somedudenamedtony/Resonance/hardware/enclosure/README.md

# Bridge enclosure

Parametric OpenSCAD case for the ESP32-S3 DevKitC-1 style board + a single-18650 battery shield.
STLs for all three variants are in `stl/` (base, lid, stack tray; the shield/cell/esp files are
preview mock-ups, don't print them).

| Variant | Outside (mm) | Ports | Good for |
|---|---|---|---|
| stack | 105 × 38 × 43 | ESP32 ports on the end, charge on the side | smallest footprint, bench |
| slim  | 105 × 68 × 32 | ESP32 ports on the end, charge on the back | velcro to the back of the NanoVNA |
| stick | 173 × 36 × 32 | ESP32 ports on the end, charge on the side | strap to a mast or tripod leg |

Before printing, measure the values marked ★ in `resonance_case.scad` (board sizes, port and
button positions) and re-export:

    openscad -D 'variant="slim"' -D 'part="base"' -o slim-base.stl resonance_case.scad

Print PLA or PETG, 0.2 mm layers, 3 walls, no supports. Base upright, lid upside down.
Snap-fit lid (`fit` = 0.3 mm clearance); the side ON/OFF button gets a flex tab in the wall, the battery LEDs show through slits, and the
ESP32 LEDs show through a light pipe (print the lid in a translucent filament for a glow).
