somedudenamedtony/Resonance/hardware/enclosure/stl/stack-base.stl

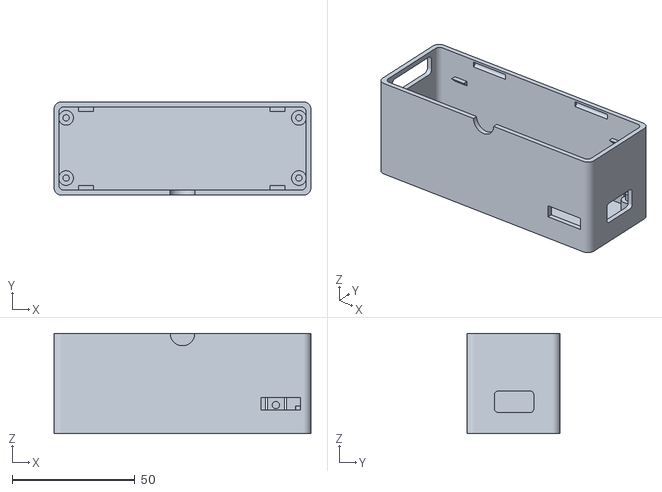
[picture p1: CAD file, 2026-10-26]
hardware/enclosure/stl/stack-base.stl
104.6 x 38.0 x 40.8
