somedudenamedtony/Resonance/hardware/enclosure/stl/stack-lid.stl

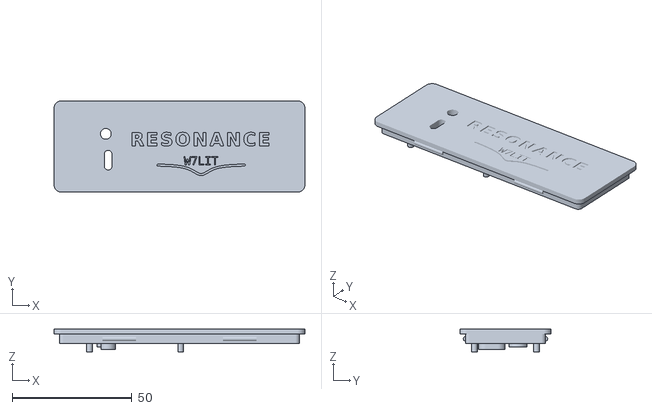
[picture p2: CAD file, 2026-10-26]
hardware/enclosure/stl/stack-lid.stl
104.6 x 38.0 x 9.40
