somedudenamedtony/Resonance/hardware/enclosure/stl/stack-esp.stl

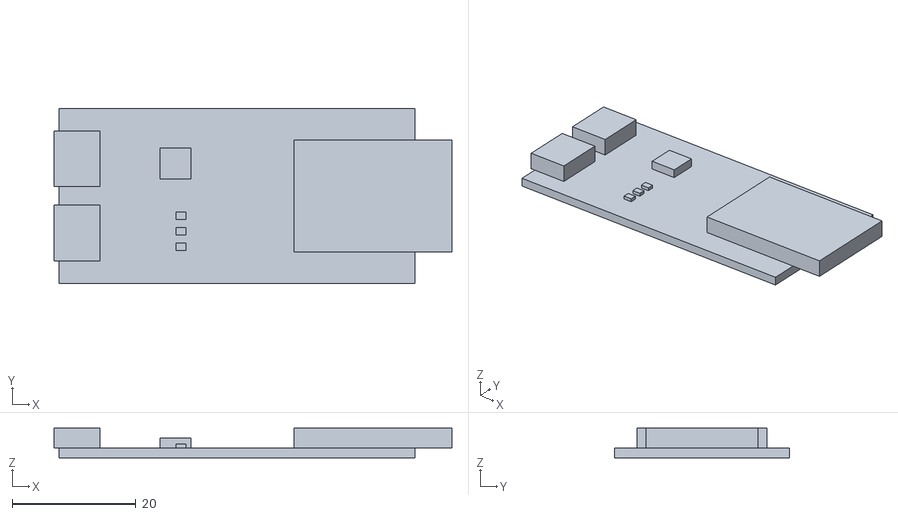
[picture p3: CAD file, 2026-10-26]
hardware/enclosure/stl/stack-esp.stl
64.3 x 28.3 x 4.80
