somedudenamedtony/Resonance/hardware/enclosure/stl/stack-tray.stl

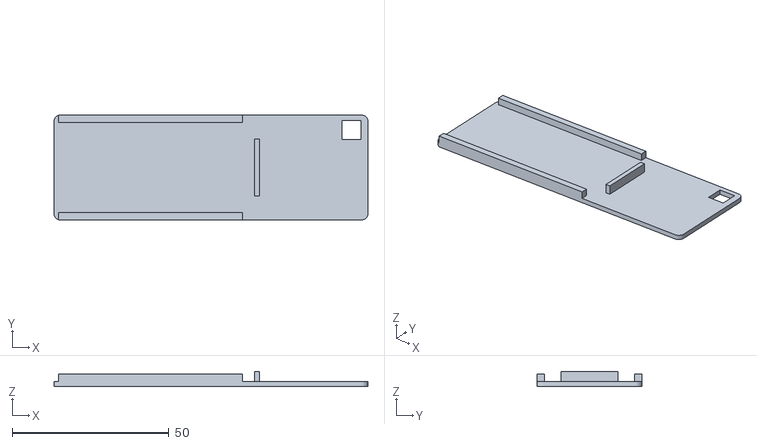
[picture p4: CAD file, 2026-10-25]
hardware/enclosure/stl/stack-tray.stl
100.0 x 33.4 x 4.70
