somedudenamedtony/Resonance/hardware/enclosure/stl/slim-shield.stl

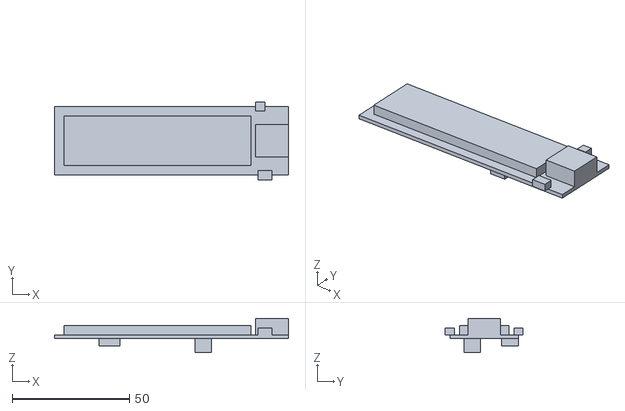
[picture p5: CAD file, 2026-10-25]
hardware/enclosure/stl/slim-shield.stl
100.0 x 33.2 x 14.6
