somedudenamedtony/Resonance/hardware/enclosure/stl/stack-cell.stl

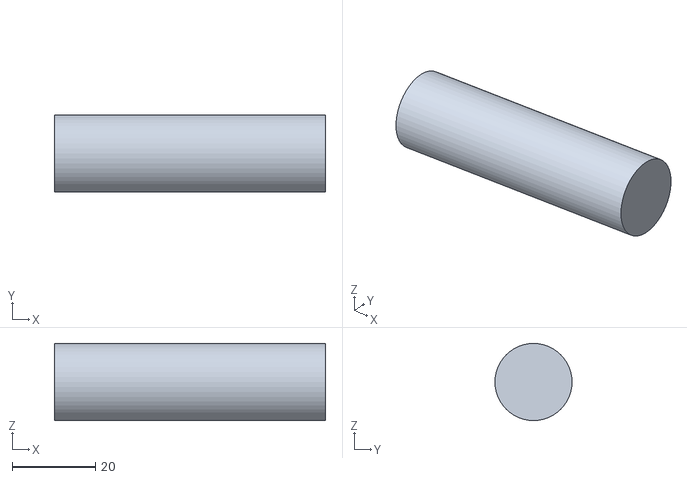
[picture p6: CAD file, 2026-10-25]
hardware/enclosure/stl/stack-cell.stl
65.0 x 18.5 x 18.5
