somedudenamedtony/Resonance/hardware/enclosure/stl/stick-base.stl

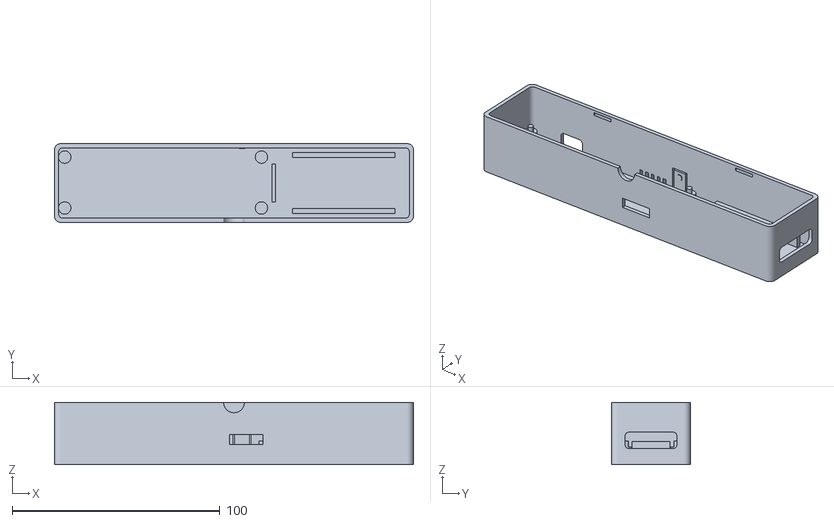
[picture p7: CAD file, 2026-10-25]
hardware/enclosure/stl/stick-base.stl
172.9 x 38.0 x 30.0
