somedudenamedtony/Resonance/hardware/enclosure/stl/stick-lid.stl

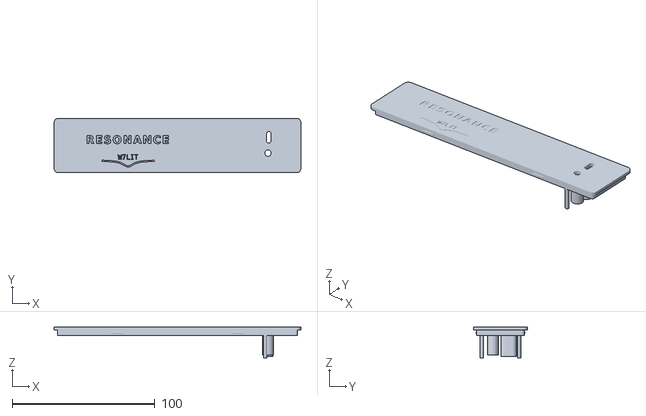
[picture p8: CAD file, 2026-10-25]
hardware/enclosure/stl/stick-lid.stl
172.9 x 38.0 x 21.7
