somedudenamedtony/Resonance/hardware/enclosure/stl/slim-base.stl

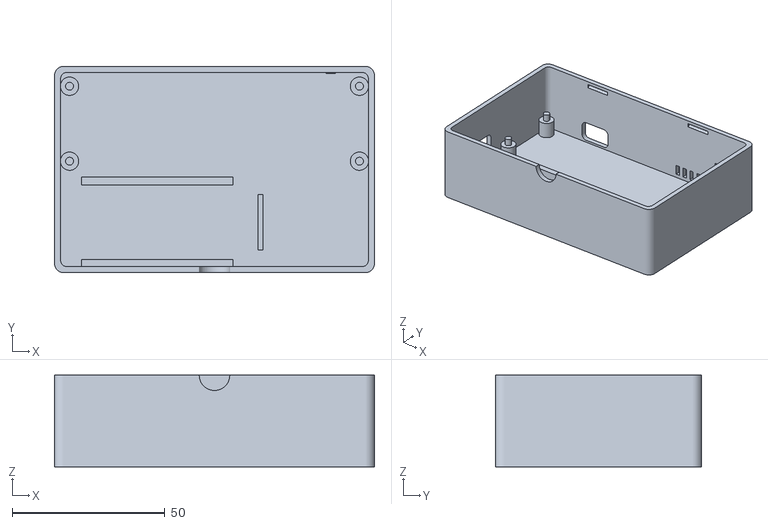
[picture p9: CAD file, 2026-10-25]
hardware/enclosure/stl/slim-base.stl
104.6 x 67.4 x 30.0
