somedudenamedtony/Resonance/hardware/enclosure/stl/slim-lid.stl

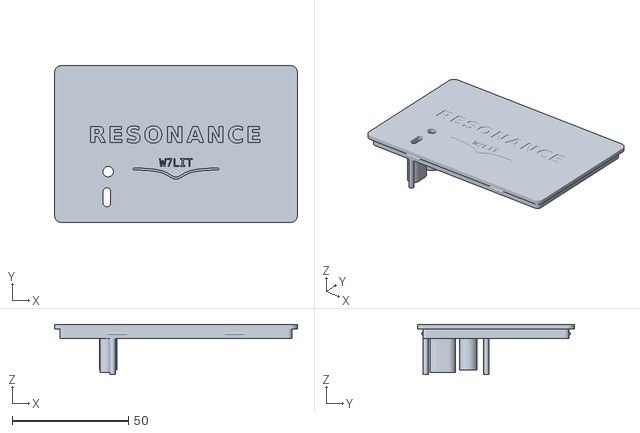
[picture p10: CAD file, 2026-10-25]
hardware/enclosure/stl/slim-lid.stl
104.6 x 67.4 x 21.7
