somedudenamedtony/Resonance/hardware/enclosure/stl/slim-cell.stl

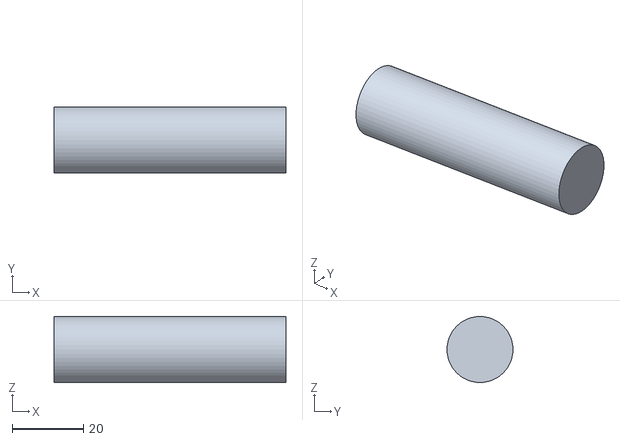
[picture p11: CAD file, 2026-10-25]
hardware/enclosure/stl/slim-cell.stl
65.0 x 18.5 x 18.5
