somedudenamedtony/Resonance/(list of files, cad)

Other CAD files:
hardware/enclosure/stl/stack-shield.stl
hardware/enclosure/stl/stick-shield.stl
hardware/enclosure/stl/stick-esp.stl
hardware/enclosure/stl/slim-esp.stl
