somedudenamedtony/Resonance/(commit log)

2026-10-16 Scaffold monorepo and start analysis library
    npm workspaces (analysis, app), shared tsconfig, README with
    milestone status checklist. Analysis: complex math, SWR/Z/RL,
    1-port OSL calibration with interpolation, standard check,
    sweep metrics (min SWR, resonance, bandwidth), US band plan.
    Claude-Session: https://claude.ai/code/session_019vR4sP8fijH1FKbvyV13yw
2026-10-16 Add spec, protocol doc, firmware skeleton and CI
    docs/SPEC.md (exported product spec), docs/PROTOCOL.md (v1 wire
    format, binary frame layout), PlatformIO ESP-IDF skeleton with a
    16 MB partition table and M1 plan, GitHub Actions for typecheck,
    test and build.
    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
    [partitions.csv]
2026-10-16 App: bridge protocol, simulator, Home and Check flow
    Preact + Vite app (17 KB gzipped). Protocol v1 codec with binary
    scan frames, BridgeClient with reconnects and progressive scans,
    in-browser simulated bridge + NanoVNA with antenna presets,
    Home, Check my antenna (band picker, live SWR trace, verdict,
    readings) and Connection screen with a command console.
    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
2026-10-16 Bridge core in portable C with unit tests
    firmware/components/resonance_core: NanoVNA shell session (echo
    matching, prompt detection, length-framed binary scans), scan
    segmentation and text/binary parsing per NanoVNA-D's scan outmask,
    protocol v1 frame encoder, and the bridge state machine (probe,
    scan, cancel/queue, raw console, detach, timeouts) using vendored
    cJSON 1.7.18. Builds as an ESP-IDF component or a host library.
    firmware/host: resonance-bridge-host (core on Linux/macOS over
    framed stdio + a serial fd) and core_tests with a scripted fake
    NanoVNA: 18 test groups, 112 checks, run under ASan/UBSan.
    Claude-Session: https://cla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
2026-10-16 Emulator stack: NanoVNA shell emulator + C bridge over a real WebSocket
    emulator/: TypeScript NanoVNA shell emulator modeled on NanoVNA-D
    (echo, CR/LF, ch> prompt, scan outmask incl. binary and no-cal
    bits, scan_bin, my_atoui parsing) plus a classic 101-point text
    dialect; open/short/load/antenna on port 1 and realistic raw
    error terms. EmulatedBridge spawns resonance-bridge-host, wires
    the serial fd to the emulator and serves ws://.../ws (and app/dist).
    Tests: 11 emulator protocol tests and 9 end-to-end tests using the
    app's real BridgeClient: probe, good verdict, classic segmentation,
    full open/short/load calibration round trip, console, unplug and
    replug mid-scan, cancel then rescan, hun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
2026-10-16 ESP32-S3 platform layer (native ESP-IDF), built in CI
    Replaces the PlatformIO placeholder with a native ESP-IDF project:
    USB host CDC-ACM link to the NanoVNA (VID/PID 0483:5740, any CDC
    device as fallback), Wi-Fi AP Resonance-XXXX with a per-device
    password (plus optional home Wi-Fi), HTTP server for the app on
    LittleFS, WebSocket at /ws, status LED, and a single bridge task
    that owns the tested resonance_core. CI builds it in
    espressif/idf:v5.3.2 and uploads flashable images.
    Not yet run on hardware.
    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
    [bridge_task.c, bridge_task.h, main.c, status_led.c, web.c, web.h]
2026-10-16 Docs: emulator stack, firmware build/flash and first-flash checklist
    SPEC/PROTOCOL now describe the no-calibration scan mask instead of
    'cal off', how the bridge frames shell responses, and resync status.
    firmware/README covers layout, host tests, ESP-IDF build, flashing
    CI artifacts with esptool, and a hardware bring-up checklist.
    README tracks M1 as code complete pending hardware.
    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
2026-10-16 Firmware: copy Wi-Fi strings without truncation warnings; fuller CI error capture
    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
    [wifi.c]
2026-10-16 M3: on-phone storage and calibration model
    app/src/storage.ts: IndexedDB store (memory fallback) with
    calibrations/profiles/sweeps/kv stores. app/src/cal.ts: stored
    calibration form, staleness (7 days or device change), applying a
    calibration only when it covers the sweep, and a UI-free guided
    open/short/load session that rejects a wrong standard. Simulator
    can present standards. Tests include a full guided calibration
    against the simulator with realistic raw errors.
    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
2026-10-16 M3: guided Calibrate screen; checks apply calibration
    Calibrate flow: open, short, load with a picture per step, wrong-
    standard rejection with a hint, progress and cancel; saves to
    IndexedDB and becomes the active calibration. Check applies it
    when it covers the scan (50 kHz-60 MHz); otherwise results carry
    an Uncalibrated badge with a link to calibrate. Status bar shows
    calibration age; Home nudges when missing, old (>7 days) or made
    on a different device.
    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
2026-10-16 M3: scan all bands and tap-to-explain readings; M3 app work done
    Check can sweep 160m-6m in one go with a one-line verdict per band
    and drill into any band. Readings explain themselves on tap (share
    of power reflected, what resonance and 2:1 width mean). Check logic
    moved to app/src/check.ts so tests share it; new e2e test runs the
    app's calibration session and check over the real C bridge.
    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
2026-10-16 M4: trim coach session (UI-free) with tests
    app/src/tune.ts: sweep ±15% around the target, find resonance
    (or say it's beyond the edge, 'or more'), one cut instruction,
    trend vs the previous sweep, SWR at target, cut log, and tracking
    of a known element length. The simulator can be physically
    trimmed (resonance scales 1/length). Tests prove a too-long 20m
    dipole reaches resonance within 3 cuts (spec success criterion).
    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
2026-10-16 M4: Tune screen; M4 app work done
    Setup (band, antenna type, target, optional element length), then
    the coach: big cut instruction, target-vs-resonance scale, trend,
    SWR at target, live re-sweep every 2 s, cut log, estimate and
    uncalibrated notes. In the simulator your cuts change the pretend
    antenna, so the whole loop can be tried without hardware.
    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
2026-10-16 M5: profiles, saved sweeps, drift, settings and backup (data layer)
    app/src/history.ts: antenna profiles, saving checks (first sweep
    per band becomes the baseline), latest per band, set/clear
    baselines, drift notes (SWR +0.3 or resonance 1% per spec),
    settings (units, SWR thresholds, theme), JSON backup export and
    import, storage estimate, metric/imperial lengths. Tests cover all.
    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
2026-10-16 M5: Antennas screens and saving checks to antennas
    Antennas tab: add an antenna (name, type, bands), list with latest
    verdict per band and a Changed badge when drift is detected.
    Antenna detail: per-band card with latest vs baseline overlay,
    drift note, history list with compare-any-two, make baseline,
    delete, delete antenna. Check: pick an antenna (its bands first,
    scan-all uses its bands), Save to antenna with an immediate drift
    note. SWR chart draws dashed overlays; checks use the SWR limits
    from settings.
    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
2026-10-16 M5: Settings, units and themes; M5 done
    Settings tab: metric/imperial (Tune setup, cut sizes and log),
    SWR limits for verdicts, Auto/Light/Dark/Sunlight themes (Sunlight
    is pure black on white with heavier lines for outdoors), calibration
    status and forget, bridge home Wi-Fi via wifi.set (BridgeClient.setWifi),
    storage used, backup download, restore from file, clear all data,
    app/bridge/NanoVNA versions.
    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
2026-10-16 M6: coax analysis (TDR, length, loss, faults) and Touchstone/CSV export
    analysis: radix-2 FFT; band-pass TDR (Hann window, zero-padded
    inverse FFT, peak height ~ |Gamma|) with parabolic peak refinement;
    coax length by TDR, refined by the open-line quarter wave on a clean
    line; loss from an open line's return loss; faults as reflections
    before the far end. Lossy coax physical model with faults for the
    simulator/emulator. Typical VF and loss for six common 50 ohm cables.
    Touchstone .s1p export/parse and CSV export. Tests: 18 m RG-8X
    length and loss, a fault found at 12 m, length through an antenna.
    Claude-Session: https://claude.ai/code/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
2026-10-16 M6: Test coax screen; simulator and emulator pretend cables
    Cable type (or custom velocity factor), far end open or antenna,
    loss frequency. Result: length, loss vs typical for the cable,
    possible faults with distance, reflection-vs-distance plot,
    resolution note, uncalibrated note. Simulator pretends 18.3 m of the
    chosen cable with a kink at 12.2 m; emulator CLI adds 'port coax'.
    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
2026-10-16 M6: Advanced view
    From any check: Smith chart with constant-R/X grid, in-band trace
    highlighted and inductive/too-long, capacitive/too-short zones; a
    marker slider (glove-friendly) with SWR, return loss, R, X, |Z|,
    Gamma and equivalent L or C; R/X and return loss vs frequency with
    the band shaded; Touchstone .s1p and CSV downloads; link to the
    console.
    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
2026-10-16 M6: NanoVNA screen capture through the bridge
    Bridge core: streaming shell mode for fixed-length bodies, screen
    size from info (Lcd:WxH, default 320x240), 'capture' message with
    capture.begin / kind-0x03 frames / capture.end. C test includes image
    bytes that look like prompts. Protocol doc updated. App: client
    capture(), RGB565BE to canvas on the Connection screen. Simulator
    and emulator render a NanoVNA-like screen with the last sweep's
    trace; end-to-end test pulls a 307 KB H4 screen through the bridge.
    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
2026-10-16 M6: ESP32 update hooks (esp_ota for firmware, raw LittleFS write for the app) + built-in /update page
    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
2026-10-25 Hardware: parametric 3D-printable enclosure (stack, slim, stick variants) + STLs
    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
    [resonance_case.scad, slim-base.stl, slim-cell.stl, slim-esp.stl, slim-lid.stl, slim-shield.stl, stack-base.stl, stack-cell.stl]
2026-10-25 Hardware: 3D viewer page for the enclosure variants
    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
2026-10-25 Enclosure: real board measurements (ESP32 28.4×63.5, shield 29.4×100, side charge port)
    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
    [resonance_case.scad, slim-base.stl, slim-cell.stl, slim-esp.stl, slim-lid.stl, slim-shield.stl, stack-base.stl, stack-cell.stl]
2026-10-25 Enclosure: side-wall ON/OFF flex tab, battery LED slits, ESP32 LED light pipe, measured holes
    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
    [resonance_case.scad, slim-base.stl, slim-esp.stl, slim-lid.stl, slim-shield.stl, stack-base.stl, stack-esp.stl, stack-lid.stl]
2026-10-25 Enclosure: fuse rails/standoffs/posts to their parts (tray rails were floating); every printable part is one watertight body
    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
    [resonance_case.scad, slim-base.stl, slim-cell.stl, slim-esp.stl, slim-lid.stl, slim-shield.stl, stack-base.stl, stack-cell.stl]
2026-10-25 Enclosure: ON/OFF wall tab hinges from below (no unsupported cantilever)
    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
    [resonance_case.scad, slim-base.stl, stack-base.stl, stick-base.stl]
2026-10-25 Show whether bridge mode joined home Wi-Fi, and its IP
    The bridge now reports its Wi-Fi to the app in a new `wifi` message: the
    home network it's joining, whether that's connecting, connected or failed,
    its IP address and signal once connected, and in plain words why the last
    attempt failed (network not found, password rejected, ...). It's sent when
    the app connects and whenever the status changes.
    Settings shows this under Bridge Wi-Fi, with the IP as a link, and fills in
    the saved network name. Older firmware never sends `wifi`; the app says the
    bridge needs an update to show it.
    Also styles the Wi-Fi password field like the other inputs, and drops the
    resonance.local claim from the Wi-F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
    [bridge_task.c, wifi.c, wifi.h]
2026-10-25 App: live SWR meter for adjusting an antenna tuner
    New SWR meter job on Home: pick a frequency, then the app re-scans a tiny
    5-point window around it back to back and shows SWR as a big colored number
    and an analog-style needle (linear in |Gamma|), with best-so-far, R+jX,
    return loss and a short trace. Simulator gets a pretend tuner knob.
    Unit tests plus an end-to-end test through the C bridge on both dialects.
    Claude-Session: https://claude.ai/code/session_0142LgRNtK2VviR7DsQsrQfM
2026-10-25 Enclosure (stack): full-length tray, LEDs un-mirrored + RGB window, SW1 lever clearance and window, softer ON/OFF tab
    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
    [resonance_case.scad, slim-base.stl, slim-esp.stl, slim-lid.stl, slim-shield.stl, stack-base.stl, stack-cell.stl, stack-esp.stl]
2026-10-25 Enclosure viewer: stack size 38 mm wide
    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
2026-10-25 Enclosure (stack): ESP32 sits flat in a walled pocket on the tray (28.8 mm, 0.2 mm/side); case 1.5 mm shorter
    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
    [resonance_case.scad, stack-base.stl, stack-esp.stl, stack-lid.stl, stack-tray.stl]
2026-10-25 Enclosure (stack): pocket walls flush with tray edges, 28.73 mm gap for the 28.34 mm board
    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
    [resonance_case.scad, stack-base.stl, stack-esp.stl, stack-lid.stl, stack-tray.stl]
2026-10-25 Enclosure (stack): USB-A opening, tray corners rounded to fit the box, antenna end stop 0.4 mm closer
    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
    [resonance_case.scad, stack-base.stl, stack-lid.stl, stack-tray.stl]
2026-10-25 Enclosure (stack): 4 lid hold-downs on the ESP32 edges; drop a zero-volume sliver from the lid STL
    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
    [resonance_case.scad, stack-lid.stl]
2026-10-25 App: chart cursor, verdicts for where you operate, Learn screen and quick start
    - Drag or arrow-key across the SWR chart to read SWR at any frequency (plus the baseline on an antenna's chart)
    - Pick CW, FT8/FT4 or SSB and checks judge that part of each band; the result can be re-judged without rescanning
    - Learn screen with short, illustrated explanations, linked from readings, verdict causes and each tool
    - Three-step quick start on first launch, reopenable from Settings or Learn
    Claude-Session: https://claude.ai/code/session_018saF8ynzUfJYZroiTW4sAY
2026-10-26 Enclosure (stack): RGB LED window 1.5 mm toward the port end (test fit)
    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
    [resonance_case.scad, stack-esp.stl, stack-lid.stl]
2026-10-26 Meter: simulator tuner knob starts at the connected antenna
    The live meter's simulator knob defaulted off center and replaced the
    connected antenna with a fixed detuned one (f0 7% above the dial, 85 ohm),
    so at 14.074 MHz it read SWR 3.08 (85-j69) while a sweep of the same
    simulated antenna read about 1.1. The knob now detunes the connected
    antenna (including any trim), starts centered, and puts the simulator's
    antenna back when the meter closes instead of clearing it.
    Claude-Session: https://claude.ai/code/session_01N1FWmDnpXj46Y1RhV2Zbg4
2026-10-26 Bridge + app: keep the NanoVNA's screen on what the app is showing
    New `display` / `display.off` messages (bridge 0.4.0, advertised as a
    `features` entry on `device`). The bridge sets the device's sweep range,
    SWR/Smith traces and markers, resumes live sweeping, and puts the view back
    once the app's scans go quiet (scans move the device's sweep and pause it).
    The app sends a view from Check (band, markers on best SWR and resonance),
    Advanced (marker follows the slider), Tune (target and current resonance)
    and the SWR meter (band, marker on the frequency), and lets go elsewhere.
    Settings > NanoVNA screen turns it off.
    Clau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
2026-10-26 Bridge: update itself from GitHub releases, with rollback
    - In bridge mode the bridge checks the repo's latest GitHub release (20 s after joining home
    Wi-Fi, every 12 h, and on request) and, when asked, downloads resonance-bridge.bin and
    littlefs.bin itself over HTTPS, writes both, and restarts once. New update.check /
    update.install messages and an `update` status message (docs/PROTOCOL.md).
    - Rollback: CONFIG_BOOTLOADER_APP_ROLLBACK_ENABLE. New firmware is kept once it joins home
    Wi-Fi or an app connects; otherwise the bootloader goes back (crash, or 5 minutes).
    - CI publishes release v<RC_BRIDGE_VERSION> with the images when main has a version that
    isn't released yet.
    - App: Set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
    [bridge_task.c, main.c, ota.c, ota.h]
2026-10-26 Enclosure (stack): stronger lid snaps (bump r 0.95, 14 mm long)
    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
    [resonance_case.scad, stack-base.stl, stack-lid.stl]
2026-10-26 Find resonance at any frequency, not just the ham bands
    New "Find resonance" job: sweep around a target, the NanoVNA's whole range
    (50 kHz to 1.5 GHz, more on a LiteVNA), or a custom start/stop. Wide ranges
    are swept in log-spaced 3:1 pieces so narrow HF dips aren't stepped over,
    SWR dips are found by prominence, and the deepest few (plus the one nearest
    the target) get a close look. Notes the lower accuracy above ~900 MHz and
    that the app's calibration stops at 60 MHz.
    Saved antennas can have a non-ham target frequency (e.g. 1090 MHz ADS-B),
    and Tune takes an "Other" target. The NanoVNA's screen follows the search.
    Simulator gains a 1090 MHz ground-plane preset. No firmware change.
    Co-Aut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
